Team865/octo-robot/docs/assets/robot_bot.png

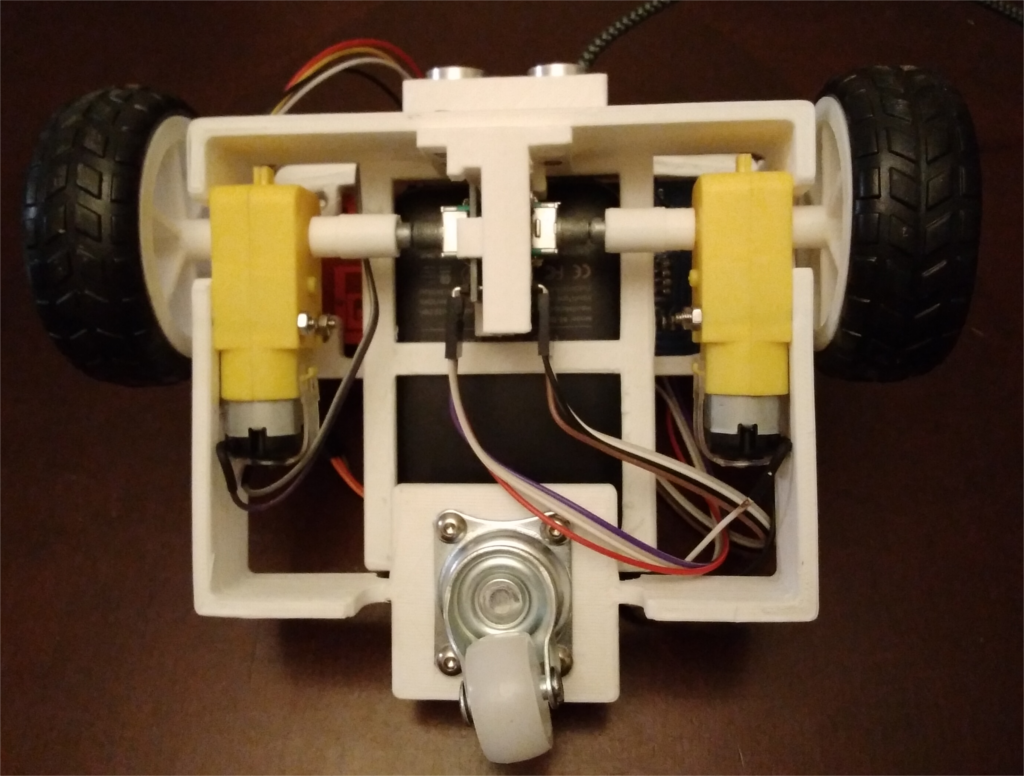
docs/assets/robot_bot.png
