Team865/octo-robot/docs/assets/robot_top.png

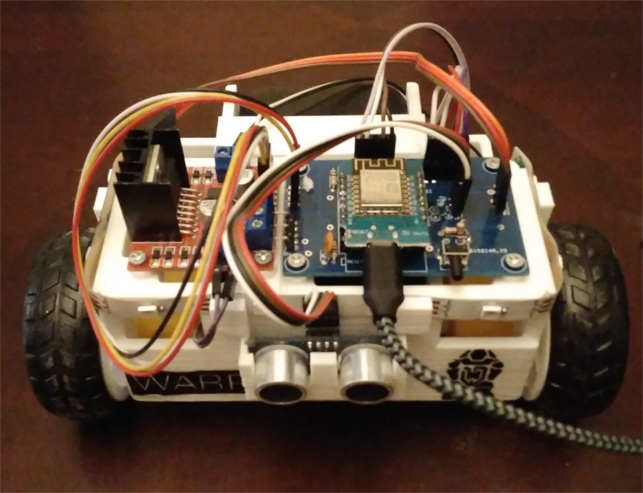
docs/assets/robot_top.png
