Team865/octo-robot/cad/NewRobotFrame/caster-wheel-roue-libre-1.snapshot.1/Caster Wheel d=20mm/Caster Wheel d=20mm.JPG

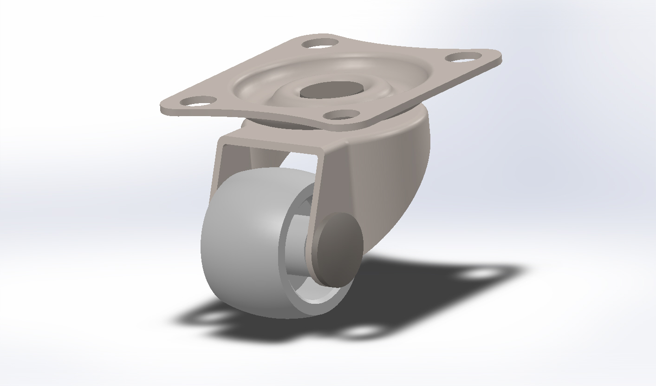
cad/NewRobotFrame/caster-wheel-roue-libre-1.snapshot.1/Caster Wheel d=20mm/Caster Wheel d=20mm.JPG
