Team865/octo-robot/docs/assets/screen_0.png

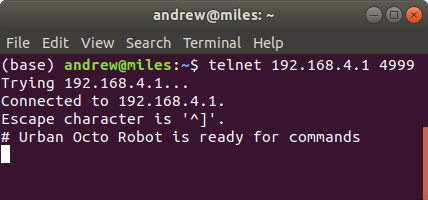
docs/assets/screen_0.png
