Team865/octo-robot/docs/assets/screen_1.png

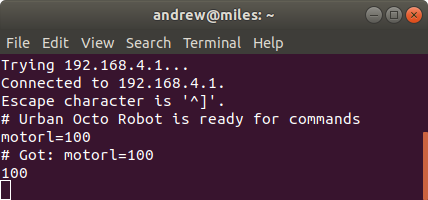
docs/assets/screen_1.png
