Team865/octo-robot/docs/assets/screen_2.png

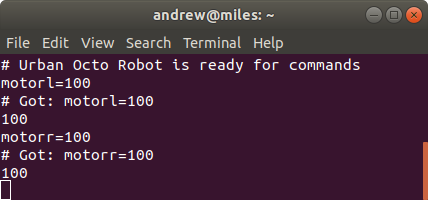
docs/assets/screen_2.png
