Team865/octo-robot/docs/assets/screen_3.png

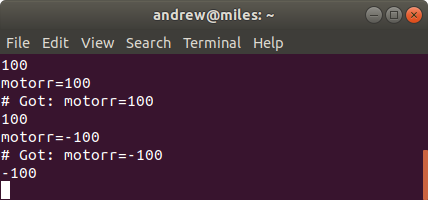
docs/assets/screen_3.png
