Team865/octo-robot/docs/assets/screen_9.png

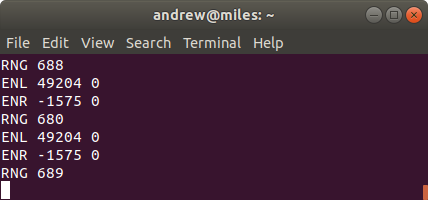
docs/assets/screen_9.png
