Team865/octo-robot/cad/NewRobotFrame/Assem2.sldasm

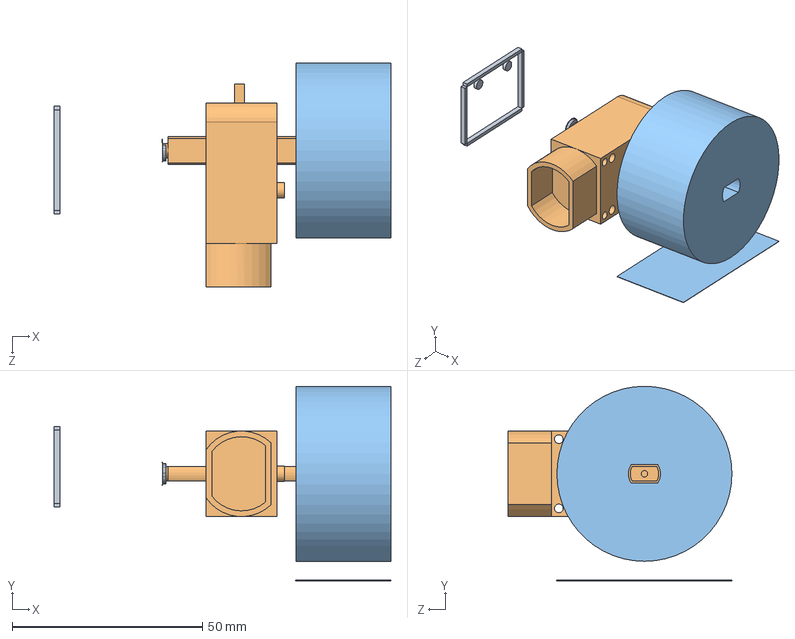
[picture p9: CAD file, 2020-09-12]
cad/NewRobotFrame/Assem2.sldasm
88.6 x 51.1 x 58.8 mm
Rotary_Encorder_Holder
Robot Wheel Motor Mount
Part1^Assem2
