Team865/octo-robot/cad/NewRobotFrame/Assem1.SLDASM

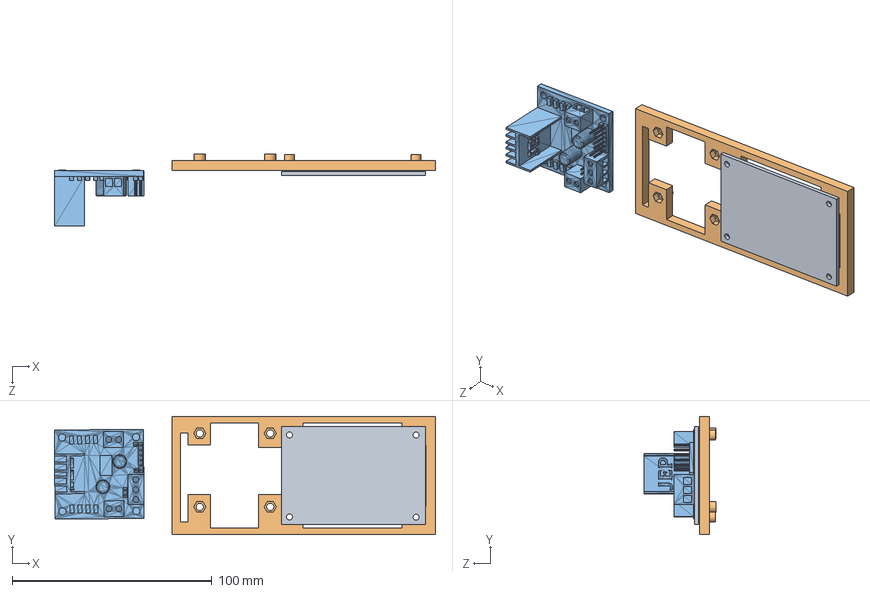
[picture p10: CAD file, 2020-09-12]
cad/NewRobotFrame/Assem1.SLDASM
190.7 x 59.2 x 36.2 mm
