Team865/octo-robot/cad/NewRobotFrame/caster-wheel-roue-libre-1.snapshot.1/Caster Wheel d=20mm/Caster Wheel d=20mm.SLDASM

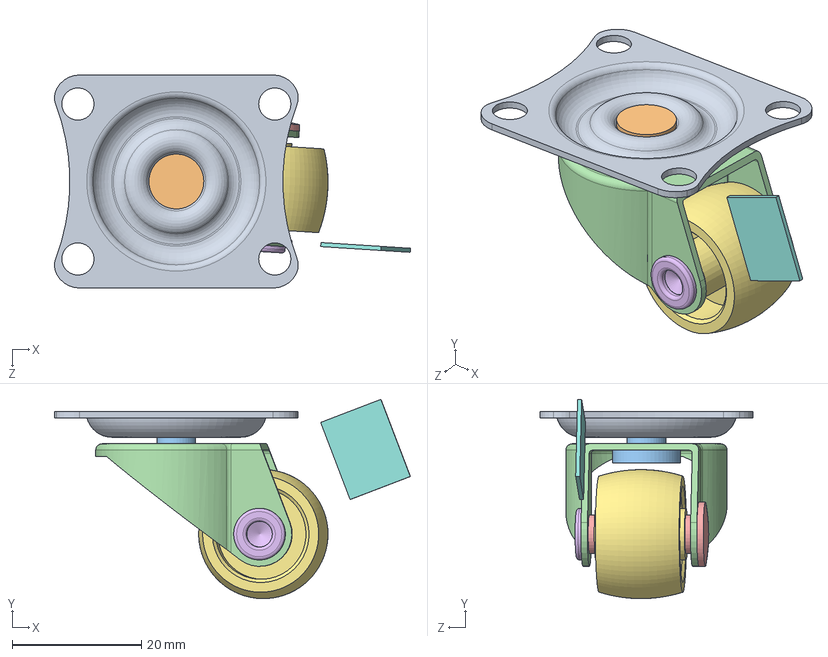
[picture p11: CAD file, 2020-09-12]
cad/NewRobotFrame/caster-wheel-roue-libre-1.snapshot.1/Caster Wheel d=20mm/Caster Wheel d=20mm.SLDASM
55.1 x 30.9 x 33.0 mm
Base
Rivet A
Rivet B
Chape
Rivet2 A
Rivet2 B
C - Galet
Part2^Caster Wheel d=20mm
