Team865/octo-robot/cad/NewRobotFrame/caster-wheel-roue-libre-1.snapshot.1/Caster Wheel d=20mm/B - Chape.SLDASM

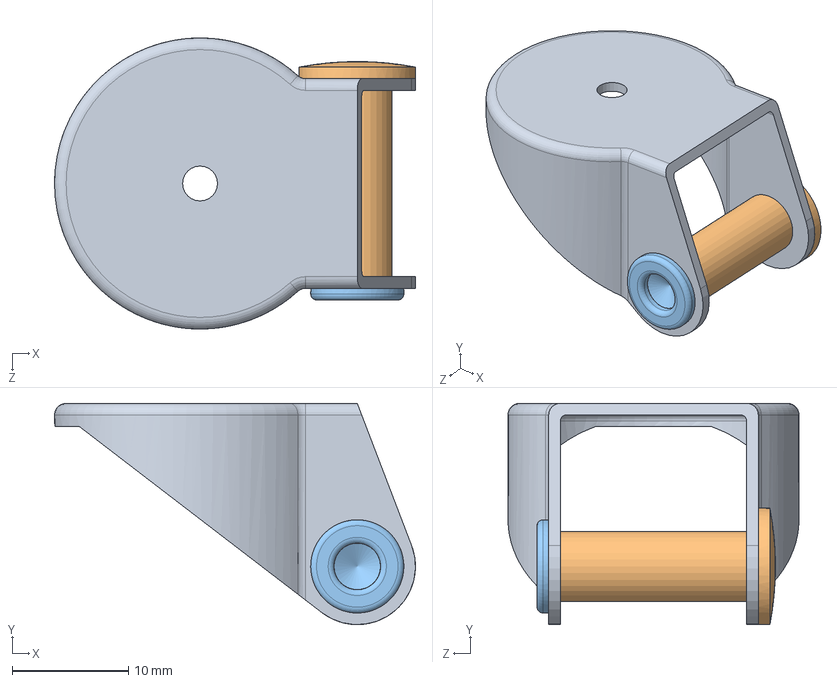
[picture p12: CAD file, 2020-09-12]
cad/NewRobotFrame/caster-wheel-roue-libre-1.snapshot.1/Caster Wheel d=20mm/B - Chape.SLDASM
31.0 x 19.0 x 25.0 mm
Chape
Rivet2 A
Rivet2 B
