Team865/octo-robot/cad/NewRobotFrame/caster-wheel-roue-libre-1.snapshot.1/Caster Wheel d=20mm/A - Base.SLDASM

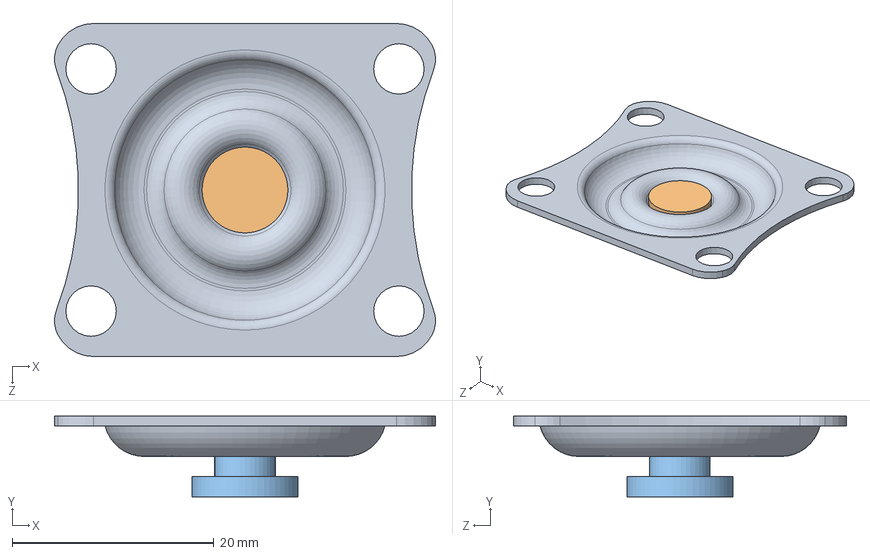
[picture p13: CAD file, 2020-09-12]
cad/NewRobotFrame/caster-wheel-roue-libre-1.snapshot.1/Caster Wheel d=20mm/A - Base.SLDASM
37.8 x 8.00 x 33.0 mm
Base
Rivet A
Rivet B
