Team865/octo-robot/cad/NewRobotFrame/caster-wheel-roue-libre-1.snapshot.1/Caster Wheel d=20mm - B - Chape-1 Rivet2 B-1.STL

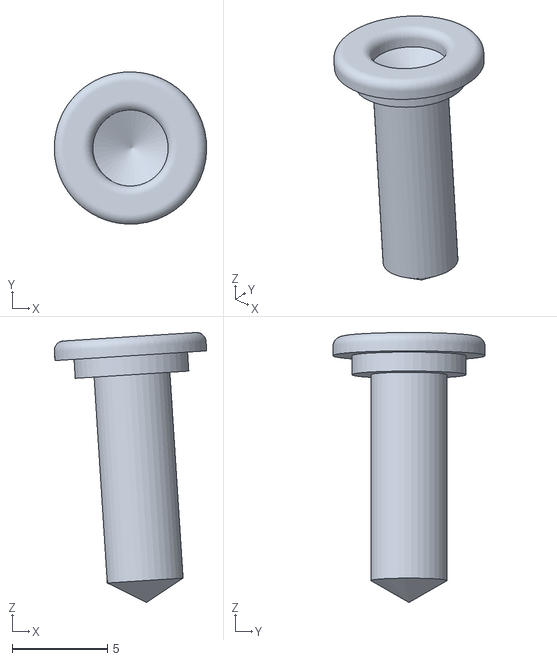
[picture p14: CAD file, 2020-09-12]
cad/NewRobotFrame/caster-wheel-roue-libre-1.snapshot.1/Caster Wheel d=20mm - B - Chape-1 Rivet2 B-1.STL
8.01 x 7.99 x 14.2
