Team865/octo-robot/cad/NewRobotFrame/caster-wheel-roue-libre-1.snapshot.1/Caster Wheel d=20mm/Base - Rivet A-1.STL

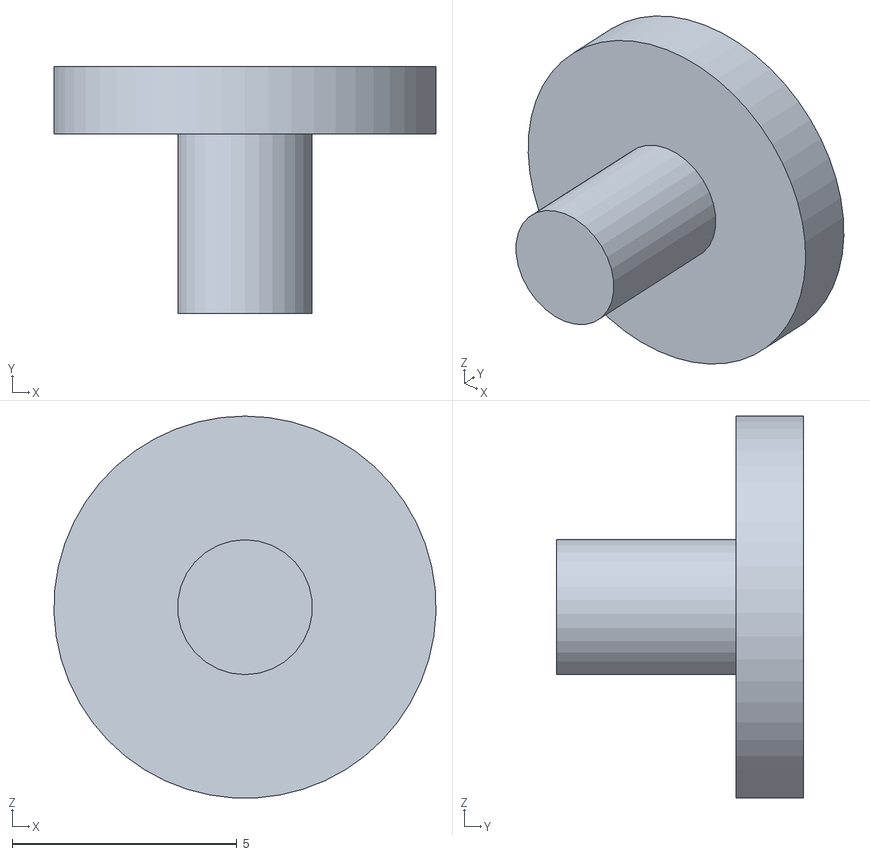
[picture p15: CAD file, 2020-09-12]
cad/NewRobotFrame/caster-wheel-roue-libre-1.snapshot.1/Caster Wheel d=20mm/Base - Rivet A-1.STL
8.50 x 5.50 x 8.49
