Team865/octo-robot/cad/rev_b/wheel.stl

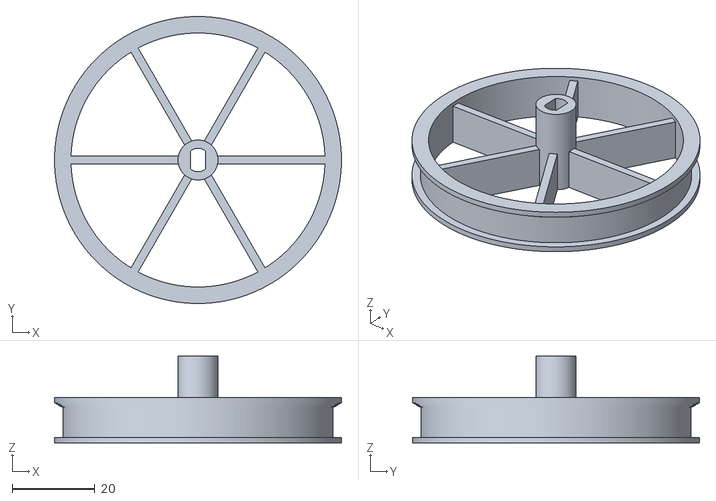
[picture p16: CAD file, 2021-10-17]
cad/rev_b/wheel.stl
69.5 x 69.5 x 21.0
