Team865/octo-robot/cad/shaft_coupler.stl

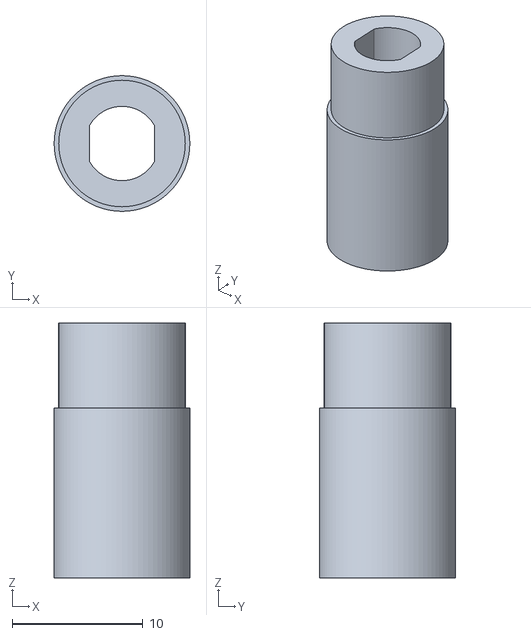
[picture p17: CAD file, 2020-08-18]
cad/shaft_coupler.stl
10.4 x 10.4 x 19.5
