Team865/octo-robot/cad/NewRobotFrame/caster-wheel-roue-libre-1.snapshot.1/Caster Wheel d=20mm/Caster Wheel d=20mm - A - Base-1 Base-1.STL

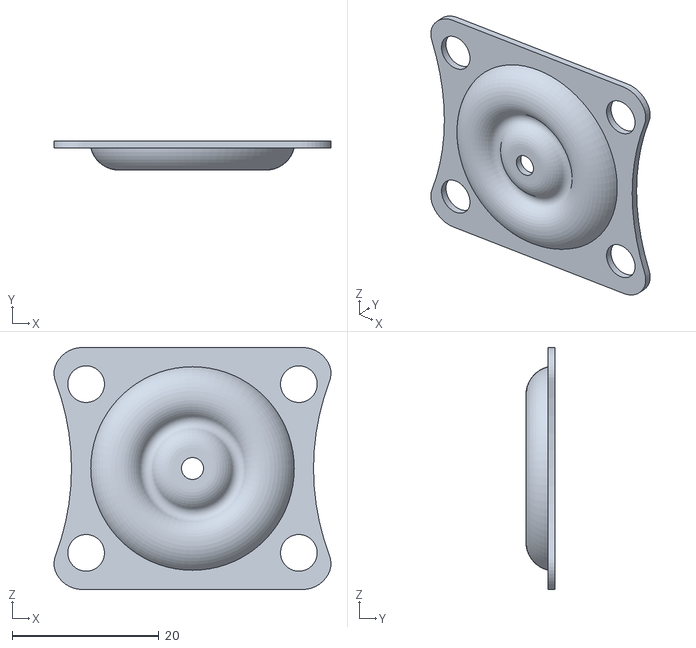
[picture p19: CAD file, 2020-09-12]
cad/NewRobotFrame/caster-wheel-roue-libre-1.snapshot.1/Caster Wheel d=20mm/Caster Wheel d=20mm - A - Base-1 Base-1.STL
37.8 x 4.00 x 33.0
