Team865/octo-robot/cad/rev_b/tire.stl

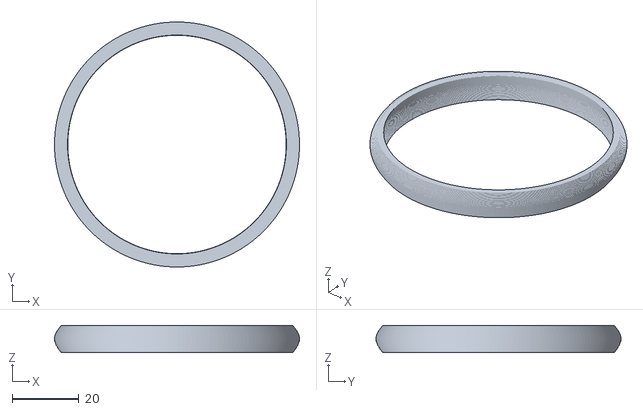
[picture p20: CAD file, 2021-10-17]
cad/rev_b/tire.stl
73.5 x 73.5 x 8.20
