Team865/octo-robot/cad/robot_model.SLDPRT

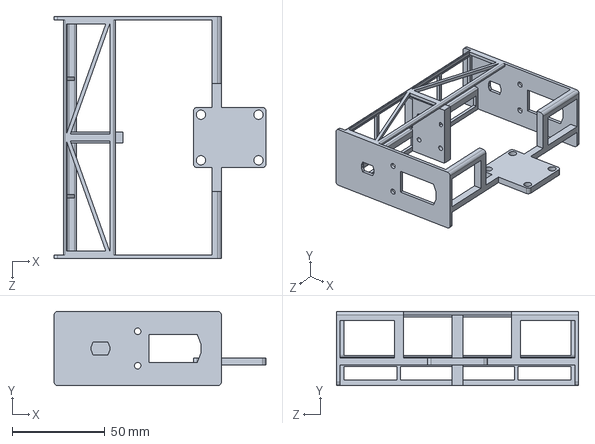
[picture p21: CAD file, 2020-07-27]
cad/robot_model.SLDPRT
114.0 x 40.0 x 130.3 mm
