Team865/octo-robot/cad/NewRobotFrame/caster-wheel-roue-libre-1.snapshot.1/Caster Wheel d=20mm - A - Base-1 Rivet B-1.STL

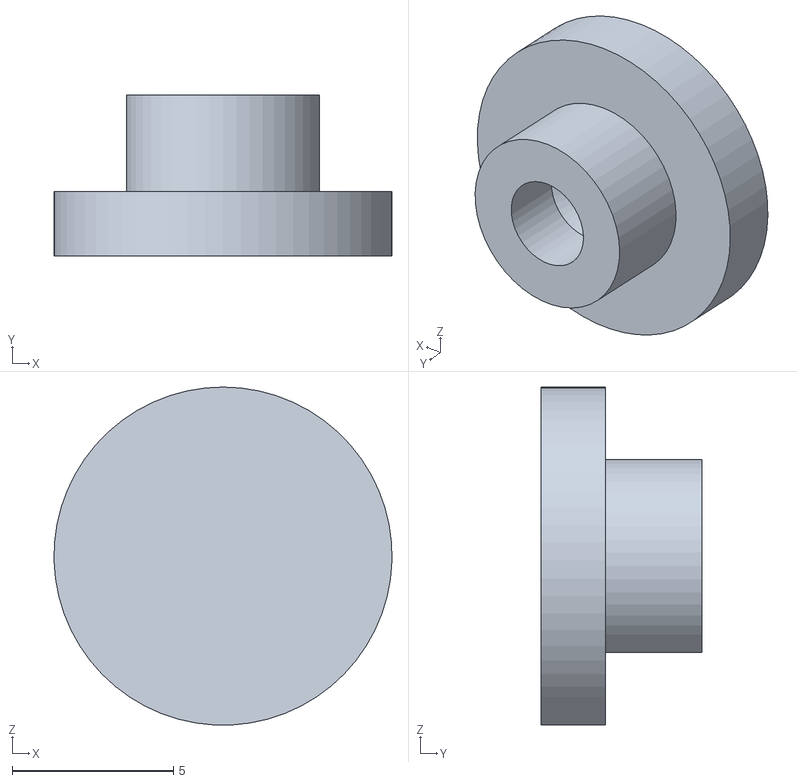
[picture p22: CAD file, 2020-09-12]
cad/NewRobotFrame/caster-wheel-roue-libre-1.snapshot.1/Caster Wheel d=20mm - A - Base-1 Rivet B-1.STL
10.5 x 5.00 x 10.5
