Team865/octo-robot/cad/NewRobotFrame/caster-wheel-roue-libre-1.snapshot.1/Caster Wheel d=20mm/Caster Wheel d=20mm - B - Chape-1 Rivet2 A-1.STL

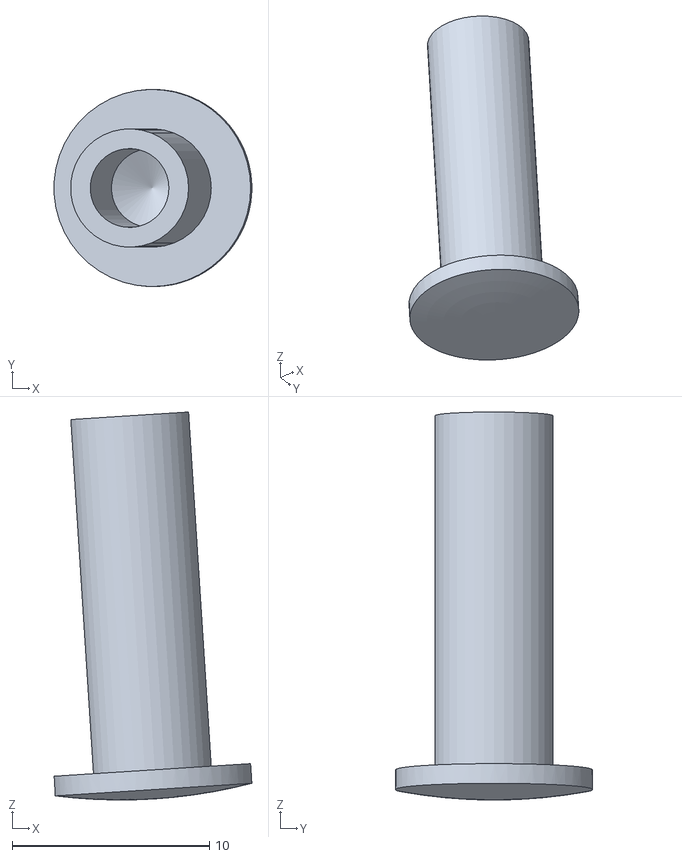
[picture p23: CAD file, 2020-09-12]
cad/NewRobotFrame/caster-wheel-roue-libre-1.snapshot.1/Caster Wheel d=20mm/Caster Wheel d=20mm - B - Chape-1 Rivet2 A-1.STL
10.0 x 10.0 x 19.7
