Team865/octo-robot/cad/NewRobotFrame/caster-wheel-roue-libre-1.snapshot.1/Caster Wheel d=20mm - B - Chape-1 Chape-1.STL

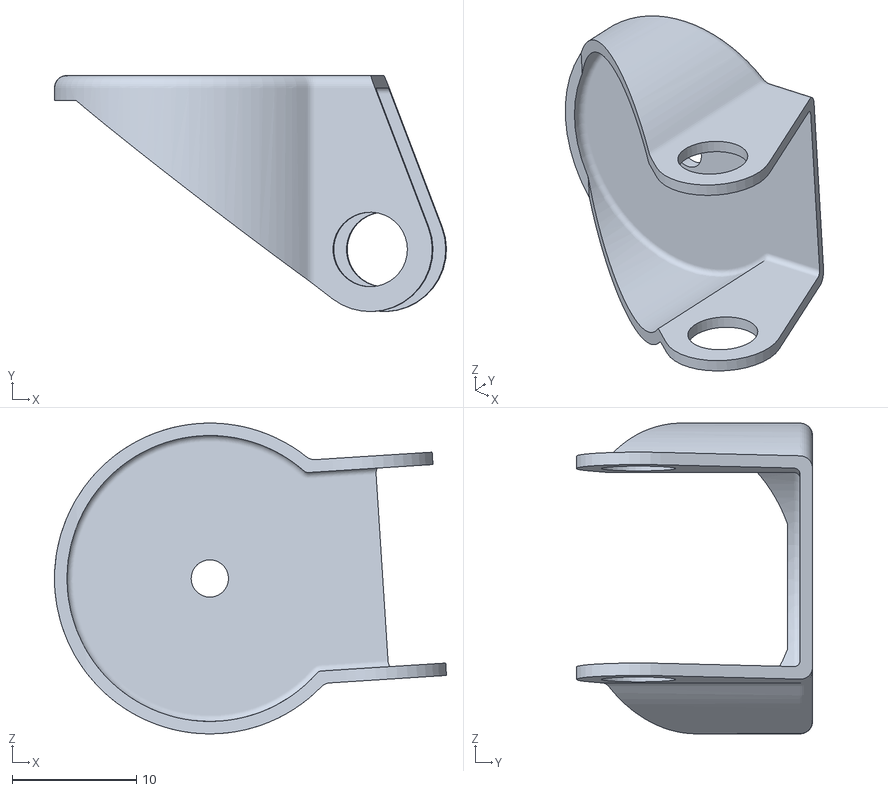
[picture p24: CAD file, 2020-09-12]
cad/NewRobotFrame/caster-wheel-roue-libre-1.snapshot.1/Caster Wheel d=20mm - B - Chape-1 Chape-1.STL
31.5 x 19.0 x 25.0
