Team865/octo-robot/cad/NewRobotFrame/caster-wheel-roue-libre-1.snapshot.1/Caster Wheel d=20mm/Rivet2 A.SLDPRT

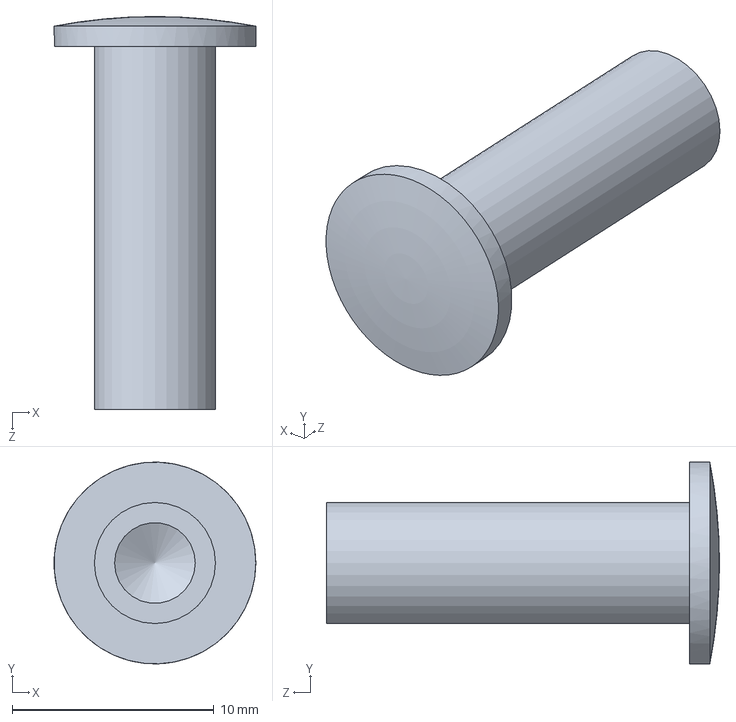
[picture p26: CAD file, 2020-09-12]
cad/NewRobotFrame/caster-wheel-roue-libre-1.snapshot.1/Caster Wheel d=20mm/Rivet2 A.SLDPRT
9.99 x 10.0 x 19.5 mm
