Team865/octo-robot/(list of files, cad)

Other CAD files:
cad/NewRobotFrame/framePrint2ButForRealsiesHopefuly.SLDPRT
cad/NewRobotFrame/caster-wheel-roue-libre-1.snapshot.1/Caster Wheel d=20mm/Caster Wheel d=20mm - A - Base-1 Base-1-1.STL
cad/NewRobotFrame/caster-wheel-roue-libre-1.snapshot.1/Caster Wheel d=20mm - A - Base-1 Rivet A-1.STL
cad/NewRobotFrame/caster-wheel-roue-libre-1.snapshot.1/Caster Wheel d=20mm/Caster Wheel d=20mm - A - Base-1 Rivet B-1-1.STL
cad/NewRobotFrame/caster-wheel-roue-libre-1.snapshot.1/Caster Wheel d=20mm/Caster Wheel d=20mm - A - Base-1 Rivet A-1.STL
cad/NewRobotFrame/caster-wheel-roue-libre-1.snapshot.1/Caster Wheel d=20mm/Base - Rivet B-1.STL
cad/NewRobotFrame/caster-wheel-roue-libre-1.snapshot.1/Caster Wheel d=20mm/Caster Wheel d=20mm - B - Chape-1 Rivet2 B-1-1.STL
cad/NewRobotFrame/caster-wheel-roue-libre-1.snapshot.1/Caster Wheel d=20mm/Galet.SLDPRT
cad/NewRobotFrame/caster-wheel-roue-libre-1.snapshot.1/Caster Wheel d=20mm/Caster Wheel d=20mm - C - Galet-1-1.STL
cad/NewRobotFrame/caster-wheel-roue-libre-1.snapshot.1/Caster Wheel d=20mm/Caster Wheel d=20mm - B - Chape-1 Rivet2 A-1-1.STL
cad/NewRobotFrame/caster-wheel-roue-libre-1.snapshot.1/Caster Wheel d=20mm/Base - Rivet B-1-1.STL
cad/NewRobotFrame/caster-wheel-roue-libre-1.snapshot.1/Caster Wheel d=20mm/Base - Base-1.STL
cad/NewRobotFrame/caster-wheel-roue-libre-1.snapshot.1/Caster Wheel d=20mm/Base - Rivet A-1-1.STL
cad/NewRobotFrame/caster-wheel-roue-libre-1.snapshot.1/Caster Wheel d=20mm/Base.SLDPRT
cad/NewRobotFrame/caster-wheel-roue-libre-1.snapshot.1/Caster Wheel d=20mm/Rivet A.SLDPRT
cad/NewRobotFrame/caster-wheel-roue-libre-1.snapshot.1/Caster Wheel d=20mm/Caster Wheel d=20mm - B - Chape-1 Chape-1-1.STL
cad/NewRobotFrame/caster-wheel-roue-libre-1.snapshot.1/Caster Wheel d=20mm/Caster Wheel d=20mm - A - Base-1 Rivet A-1-1.STL
cad/NewRobotFrame/caster-wheel-roue-libre-1.snapshot.1/Caster Wheel d=20mm/Base - Base-1-1.STL
cad/NewRobotFrame/caster-wheel-roue-libre-1.snapshot.1/Caster Wheel d=20mm/C - Galet.SLDPRT
cad/NewRobotFrame/caster-wheel-roue-libre-1.snapshot.1/Caster Wheel d=20mm/Rivet B.SLDPRT
cad/NewRobotFrame/caster-wheel-roue-libre-1.snapshot.1/Caster Wheel d=20mm/Rivet2 B.SLDPRT
cad/shaft_coupler.scad
cad/NewRobotFrame/caster-wheel-roue-libre-1.snapshot.1/Caster Wheel d=20mm/Caster Wheel d=20mm.IGS
