Team865/octo-robot/pcbs/rev_b/main.brd

## EAGLE design pcbs/rev_b/main.brd (2021-10-17)

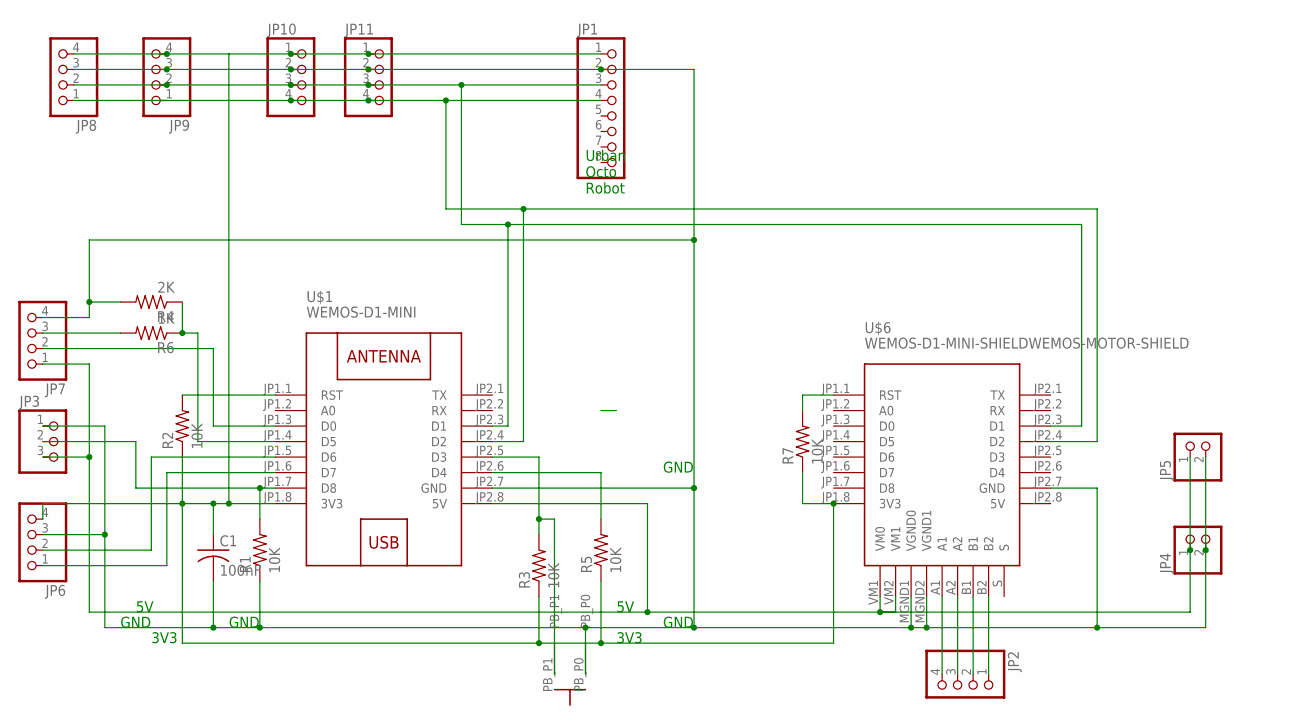
[picture p35: schematic main.sch]

Parts:
C1: 100nF; C050-024X044
JP1: PINHD-1X8; 1X08
JP2: PINHD-1X4/90; 1X04/90
JP3: PINHD-1X3; 1X03
JP4, JP5: PINHD-1X2; 1X02
JP6, JP7, JP8, JP9, JP10, JP11: PINHD-1X4; 1X04
R1, R2, R3, R5, R7: 10K; 0204/7
R4: 2K; 0309V
R6: 1K; 0309V
U$1: WEMOS-D1-MINI
U$6: WEMOS-D1-MINI-SHIELDWEMOS-MOTOR-SHIELD; WEMOS-D1-MINI-SHIELD
U$7: BUTTON6X6X10MMSIDE

Connections:
5V: U$6.JP2.8 (5V)
unnamed: JP2.4, U$6.A1
unnamed: R7.2, U$6.JP1.1 (RST)
unnamed: JP3.3, JP4.1, JP5.1, JP7.1, U$1.JP2.8 (5V), U$6.VM1 (VM0), U$6.VM2 (VM1)
unnamed: JP7.3, R6.2
unnamed: JP2.3, U$6.A2
unnamed: JP6.2, U$1.JP1.5 (D6)
unnamed: R5.2, U$1.JP2.6 (D4)
unnamed: R4.1, R6.1, U$1.JP1.4 (D5)
unnamed: R2.2, U$1.JP1.1 (RST)
unnamed: JP3.2, R1.2, U$1.JP1.7 (D8)
unnamed: JP2.2, U$6.B1
unnamed: JP2.1, U$6.B2
unnamed: R3.2, U$1.JP2.5 (D3), U$7.PB_P1
unnamed: JP7.2, U$1.JP1.3 (D0)
unnamed: JP6.1, U$1.JP1.6 (D7)
unnamed: C1.1, JP1.1, JP6.4, JP8.4, JP9.4, JP10.1, JP11.1, R2.1, R3.1, R5.1, R7.1, U$1.JP1.8 (3V3), U$6.JP1.8 (3V3)
unnamed: C1.2, JP1.2, JP3.1, JP4.2, JP5.2, JP6.3, JP7.4, JP8.3, JP9.3, JP10.2, JP11.2, R1.1, R4.2, U$1.JP2.7 (GND), U$6.JP2.7 (GND), U$6.MGND1 (VGND0), U$6.MGND2 (VGND1), U$7.PB_P0
unnamed: JP1.3, JP8.2, JP9.2, JP10.3, JP11.3, U$1.JP2.3 (D1), U$6.JP2.3 (D1)
unnamed: JP1.4, JP8.1, JP9.1, JP10.4, JP11.4, U$1.JP2.4 (D2), U$6.JP2.4 (D2)

Notes on the sheet:
GND
3V3
Urban Octo Robot

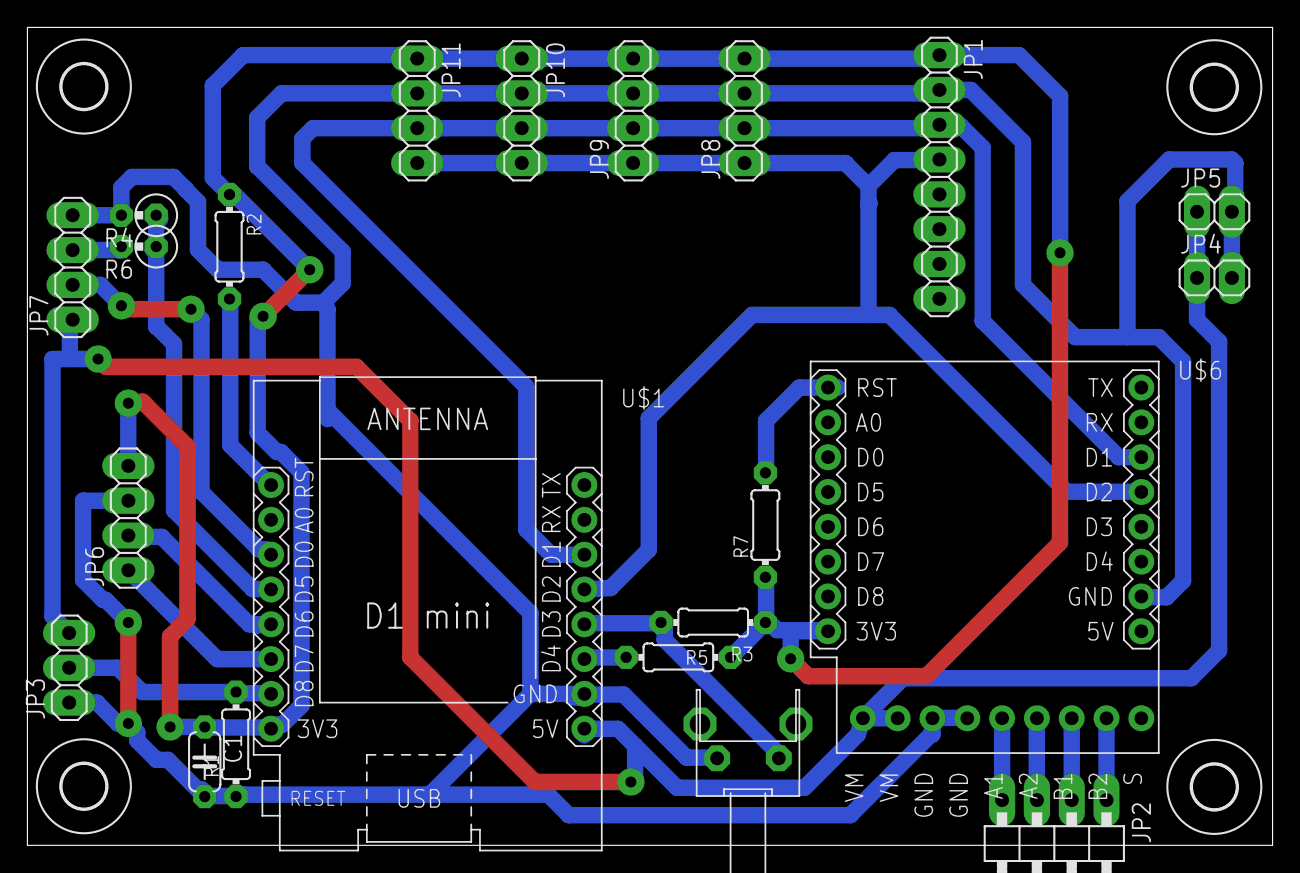
[picture p36: board pcbs/rev_b/main.brd from above]

Board: 2 copper layers, 90.9 x 59.7 mm, 26 parts (0 on the bottom side), 19 nets.

Other parts of the board:
U$2, U$3, U$4, U$5: 3,2
