Team865/octo-robot/pcbs/rev_a/main.brd

## EAGLE design pcbs/rev_a/main.brd (2020-08-18, an earlier design)

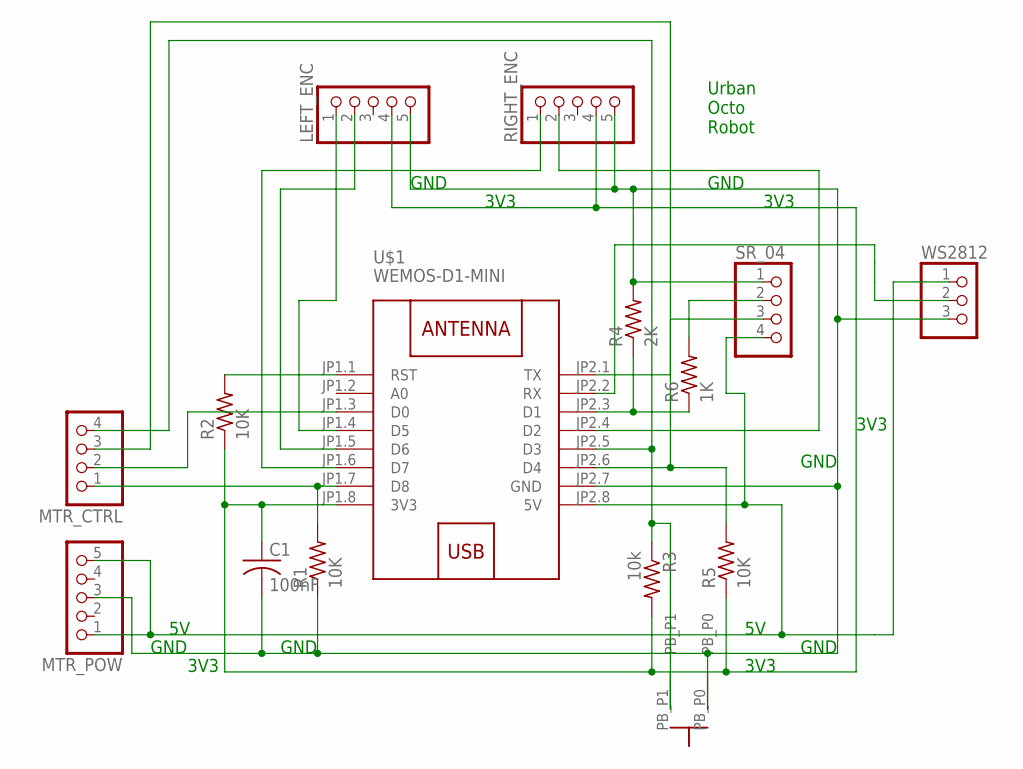
[picture p37: schematic main.sch]

Parts:
C1: 100nF; C050-024X044
LEFT_ENC: PINHD-1X5; 1X05
MTR_CTRL: PINHD-1X4; 1X04
MTR_POW: PINHD-1X5/90; 1X05/90
R1, R2, R5: 10K; 0204/7
R3: 10k; 0207/2V
R4: 2K; 0309V
R6: 1K; 0309V
RIGHT_ENC: PINHD-1X5; 1X05
SR_04: PINHD-1X4; 1X04
U$1: WEMOS-D1-MINI
U$7: BUTTON6X6X10MMSIDE
WS2812: PINHD-1X3; 1X03

Connections:
unnamed: U$1.JP2.2 (RX), WS2812.2
unnamed: MTR_POW.1, MTR_POW.5, SR_04.4, U$1.JP2.8 (5V), WS2812.1
unnamed: LEFT_ENC.1, U$1.JP1.4 (D5)
unnamed: MTR_CTRL.2, U$1.JP1.3 (D0)
unnamed: RIGHT_ENC.2, U$1.JP2.4 (D2)
unnamed: LEFT_ENC.2, U$1.JP1.5 (D6)
unnamed: RIGHT_ENC.1, U$1.JP1.6 (D7)
unnamed: C1.1, LEFT_ENC.4, R2.1, R3.2, R5.1, RIGHT_ENC.4, U$1.JP1.8 (3V3)
unnamed: R6.2, SR_04.2
unnamed: MTR_CTRL.4, R3.1, U$1.JP2.5 (D3), U$7.PB_P1
unnamed: R4.1, R6.1, U$1.JP2.3 (D1)
unnamed: SR_04.3, U$1.JP2.1 (TX)
unnamed: MTR_CTRL.3, R5.2, U$1.JP2.6 (D4)
unnamed: R2.2, U$1.JP1.1 (RST)
unnamed: MTR_CTRL.1, R1.2, U$1.JP1.7 (D8)
unnamed: C1.2, LEFT_ENC.5, MTR_POW.3, R1.1, R4.2, RIGHT_ENC.5, SR_04.1, U$1.JP2.7 (GND), U$7.PB_P0, WS2812.3

Notes on the sheet:
GND
3V3
Urban Octo Robot

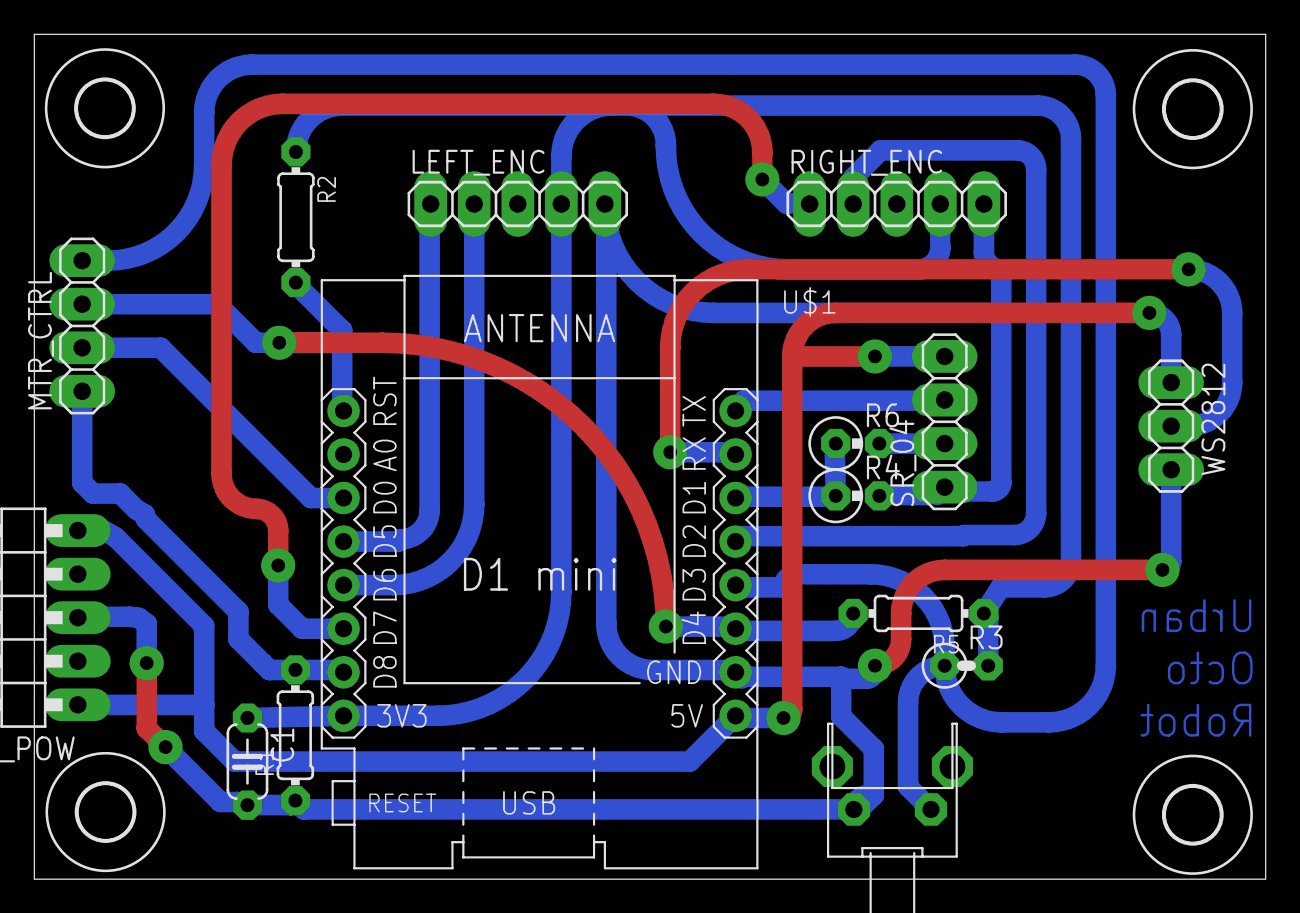
[picture p38: board pcbs/rev_a/main.brd from above]

Board: 2 copper layers, 71.8 x 49.3 mm, 19 parts (0 on the bottom side), 16 nets.

Other parts of the board:
U$2, U$3, U$4, U$5: 3,2
