Team865/octo-robot/firmware/firmware_v2/hardware_esp8266.cpp

#include <ESP8266WiFi.h>
#include <Adafruit_NeoPixel.h>
#include "hardware_esp8266.h"
#include <memory>
#include "Wire.h"

namespace
{
const std::unordered_map<HW::Pin, int, EnumHash > pinMap = 
{
  { HW::Pin::SR04_TRIG,       16    },
  { HW::Pin::SR04_ECHO,       14    },
  { HW::Pin::LED_PIN,         15    }
};

constexpr int LOCAL_LED_PIN=15;

const std::vector< HW::Pin > interruptInputs = {
  HW::Pin::SR04_ECHO
};

const std::unordered_map<HW::PinState, int, EnumHash > pinStateMap = {
  { HW::PinState::MOTOR_POS,      HIGH  },
  { HW::PinState::MOTOR_NEG,      LOW   },
  { HW::PinState::ECHO_ON,        HIGH  },
  { HW::PinState::ECHO_OFF,       LOW   }
};

class InputInterruptHandler
{
  public:

  InputInterruptHandler( std::shared_ptr< Time::HST> hstArg, HW::Pin pin )
    : hst{ hstArg }
  {
    // Cache the actual pin
    esp8266Pin = pinMap.at( pin ); 
  }
  
  void ICACHE_RAM_ATTR interrupt()
  {
    // Record the pin state & time, and get out of here.
    events.write( Util::IPinEvent(
        digitalRead( esp8266Pin ) == HIGH ? 
            HW::PinState::INPUT_HIGH : 
            HW::PinState::INPUT_LOW,
        hst->usSinceDeviceStart())
    );
  }

  HW::IEvent& getEvents() {
    return events;
  }

  private:
  HW::IEvent events;
  std::shared_ptr< Time::HST > hst; 
  int esp8266Pin;
};

std::array<int, static_cast<size_t>(HW::Pin::END_OF_PINS)  > fastAbstractToRealPin;
std::array<int, static_cast<size_t>(HW::PinState::END_OF_PIN_STATES) > fastAbstractToRealPinState; 
std::array<std::unique_ptr<InputInterruptHandler>, static_cast<size_t>(HW::Pin::END_OF_PINS ) > pinToInputHandler;

//
// Programming with raw pointers and arrays, just like the 90s.
// The ESP8266 interrupt handler HAS to be in RAM.  Raw arrays and
// smart pointers aren't good C++ anymore, but in this case they're
// easy to reason about.
// 
InputInterruptHandler* pinToInputHandlerRaw[ static_cast<size_t>(HW::Pin::END_OF_PINS) ];


void ICACHE_RAM_ATTR echoPinInt()
{
  InputInterruptHandler* handler = pinToInputHandlerRaw[ static_cast<size_t>(HW::Pin::SR04_ECHO ) ];
  handler->interrupt();
}


Adafruit_NeoPixel strip = Adafruit_NeoPixel( 8, LOCAL_LED_PIN, NEO_GRB + NEO_KHZ800 );

} // end anonymous namespace

namespace HW {
HardwareESP8266::HardwareESP8266( std::shared_ptr< Time::HST> hst )
{
  Wire.begin();
  //sw.enablePullups(true);
  sw.setDelay_us(5);
  sw.setTimeout(1000);
  sw.setTxBuffer(swTxBuffer, sizeof(swTxBuffer));
  sw.setRxBuffer(swRxBuffer, sizeof(swRxBuffer));
  sw.begin();
  // create cache for pin id
  for ( size_t index = 0 ; index < fastAbstractToRealPin.size(); ++index ) 
  {
    fastAbstractToRealPin[ index ] = 0;
  }
  for ( const auto& entry :  pinMap ) 
  {
    size_t index = static_cast<size_t>(entry.first);
    if ( index >= fastAbstractToRealPin.size() ) {
      for (;; );    // think of it like an assert
    }
    fastAbstractToRealPin[ index ] = entry.second;
  }
  // create cache for pin state
  for ( size_t index = 0 ; index < fastAbstractToRealPinState.size(); ++index ) 
  {
    fastAbstractToRealPinState[ index ] = 0;
  }
  for ( const auto& entry : pinStateMap) 
  {
    size_t index = static_cast<size_t>(entry.first);
    if ( index >= fastAbstractToRealPinState.size() ) {
      for (;; );    // think of it like an assert
    }
    fastAbstractToRealPinState[ index ] = entry.second;
  }


  // todo - constants
  pinMode( pinMap.at( Pin::SR04_TRIG ), FUNCTION_3 );
  pinMode( pinMap.at( Pin::LED_PIN),    FUNCTION_3 );
  pinMode( pinMap.at( Pin::LED_PIN),    OUTPUT );


  for ( size_t index = 0; index < static_cast<size_t>(HW::Pin::END_OF_PINS); ++index ) {
    pinToInputHandlerRaw[ index ] = nullptr;
  }
  for( Pin interruptInput : interruptInputs ) 
  {
    size_t slot = static_cast<size_t>(interruptInput);
    pinToInputHandler[ slot ] = std::unique_ptr<InputInterruptHandler>( new InputInterruptHandler(hst, interruptInput ));
    pinToInputHandlerRaw[ slot ] = pinToInputHandler[ slot ].get();
  }


  pinMode( pinMap.at( Pin::SR04_ECHO     ), INPUT );
  attachInterrupt( digitalPinToInterrupt( pinMap.at( Pin::SR04_ECHO) ), echoPinInt, CHANGE );
  strip.begin();

  for ( int i = 0; i < 8; ++i ) {
    LEDSet( i, 0, 128, 0 );
  }
  LEDUpdate();
}

void HardwareESP8266::DigitalWrite( Pin pin, PinState state )
{
  digitalWrite( 
      fastAbstractToRealPin     [ static_cast<size_t> (pin)   ],
      fastAbstractToRealPinState[ static_cast<size_t> (state) ] );
}

void HardwareESP8266::PinMode( Pin pin, PinIOMode mode )
{
  int actualPin = pinMap.at( pin );
  pinMode( actualPin, mode == PinIOMode::M_OUTPUT ? OUTPUT : INPUT );
}

HW::PinState HardwareESP8266::DigitalRead( Pin pin)
{
  const int actualPin = fastAbstractToRealPin[ static_cast<size_t>( pin ) ];
  const int actualState = digitalRead( actualPin );
  return actualState == HIGH ? PinState::INPUT_HIGH : PinState::INPUT_LOW;
}

unsigned int HardwareESP8266::AnalogRead( Pin pin)
{
  (void) pin;
  return analogRead( A0 );
}

IEvent& HardwareESP8266::GetInputEvents( Pin pin )
{
  auto& handler = pinToInputHandler[ static_cast<size_t>( pin ) ];
  return handler->getEvents();
}

void HardwareESP8266::LEDSet( unsigned int led, unsigned char r, unsigned char g, unsigned char b )
{
  strip.setPixelColor( led, strip.Color( r, g, b ));
}

void HardwareESP8266::LEDUpdate()
{
  strip.show();
}
}
