Team865/octo-robot/firmware/firmware_v2/command_motor.cpp

#include "command_motor.h"
#include "wifi_debug_ostream.h"

namespace Command{
//=======================================================================
Motor::Motor( 
  std::shared_ptr<HW::I> hwiArg,
  std::shared_ptr<DebugInterface> debugArg,
  int motorNumArg
) :
    dir { _STOP }, speedAsPercent{ 0 }, counter{ 0 }, debug{debugArg}, hwi{hwiArg}, motorNum{motorNumArg}
{
    int nDevices;
    int address;
    bool error;

    (*debugArg) << "Motor Up\n";
    (*debugArg) << "Scanning Bus 0 Devices...\n";
    nDevices = 0;
    for(address = 1; address < 127; address++){
        hwi->WireBeginTransmission(0, address);
        error = hwi->WireEndTransmission(0);
        if(error){
            (*debug) << "I2C device found at address " << address << "\n";
        }
    }

    (*debugArg) << "Scanning Bus 1 Devices...\n";
    nDevices = 0;
    for(address = 1; address < 127; address++){
        hwi->WireBeginTransmission(1, address);
        error = hwi->WireEndTransmission(1);
        if(error){
            (*debug) << "I2C device found at address " << address << "\n";
        }
    }
    //Set frequency
    int freq = 1000;
    hwi->WireBeginTransmission(0, 30);
    hwi->WireWrite(0, ((freq >> 16) & 0xff) & 0x0f );
    hwi->WireWrite(0, (freq >> 16)  & 0xff );
    hwi->WireWrite(0, (freq >> 8 )  & 0xff );
    hwi->WireWrite(0, (freq >> 0 )  & 0xff );
    hwi->WireEndTransmission(0);
}

//
// Standard execute method
//
// Controls the speed of the motor by pulsing power to the motor.  If the
// motor is 50% on then execute generates a pulse that's "on" 50% of the
// time.  If the motor is 75% on, the pulse is "on" 75% of the time.
//
// See https://socratic.org/questions/how-do-you-calculate-the-period-and-frequency for terms
// 
// 1. Figure out if we're turning the motor on or off.
// 2. Figure out the pulse duration.  This is a function of speed
// 3. Early exit if we're spending no time in the current state
// 4. Set the hardware to the new state
// 5. Tell the schedule to pause, as per the pulse's duration
// 
Time::TimeUS Motor::execute() 
{

  return Time::TimeUS(100000);
}

//
// Set the current speed and direction
// 
void Motor::setSpeed( int percent )
{
  int pwr_val;
  bool error;
  dir = percent >= 0 ? _CW :
    percent <= 0 ? _CCW : _STOP;
  speedAsPercent = percent >= 0 ? percent : -percent;

  pwr_val = speedAsPercent*100;
  pwr_val = pwr_val > 10000 ? 100000 : pwr_val;
  hwi->WireBeginTransmission(0, 0x30);
  hwi->WireWrite(0, motorNum | 0x10);
  hwi->WireWrite(0, dir);
  hwi->WireWrite(0, pwr_val >> 8);
  hwi->WireWrite(0, pwr_val);
  error = hwi->WireEndTransmission(0);
  if(error){
      (*debug) << "Transmission success";
  }
  else{
      (*debug) << "Transmission failure";
  }
}


//
// Get debug name
//  
const char* Motor::debugName()
{
  return "L298 Motor Control";
}


} // End Command Namespace


#ifdef TODO
#include "WEMOS_Motor.h"

int pwm;

//Motor shiled I2C Address: 0x30
//PWM frequency: 1000Hz(1kHz)
Motor M1(0x30,_MOTOR_A, 1000);//Motor A
Motor M2(0x30,_MOTOR_B, 1000);//Motor B


void setup2() {
  Serial.begin(115200);
}

void loop2() {

  for (pwm = 0; pwm <= 100; pwm++)
  {
    M1.setmotor( _CW, pwm);
    M2.setmotor(_CW, 100-pwm);
    Serial.printf("A:%d%, B:%d%, DIR:CW\r\n", pwm,100-pwm);
  }
  
  M1.setmotor(_STOP);
  M2.setmotor( _STOP);
  Serial.println("Motor A&B STOP");
  delay(200);
  
  for (pwm = 0; pwm <=100; pwm++)
  {
    M1.setmotor(_CCW, pwm);
    M2.setmotor(_CCW, 100-pwm);
    Serial.printf("A:%d%, B:%d%, DIR:CCW\r\n", pwm,100-pwm);

  }
  
  M1.setmotor(_STOP);
  M2.setmotor( _STOP);
  delay(200);
  Serial.println("Motor A&B STOP");

  M1.setmotor(_SHORT_BRAKE);
  M2.setmotor( _SHORT_BRAKE);
  Serial.println("Motor A&B SHORT BRAKE");  
  delay(1000);
  
  M1.setmotor(_STANDBY);//Both Motor standby
  //M2.setmotor( _STANDBY);
  Serial.println("Motor A&B STANDBY");  
  delay(1000);
  
}

#endif
