Team865/octo-robot/(commit log)

2020-06-06 Initial modifications. Set up a command wrangler to parse and send commands to devices.
2020-06-06 Fix ESP8266 specific code.
    [command_parser.h, command_wrangler.h, hardware_esp8266.cpp, main.cpp]
2020-06-06 Motor controller now works for a single motor
2020-06-07 fix compile bugs caused by file removal
    [command_wrangler.h]
2020-06-07 Switch the time since 1970 interface into a typesafe into
2020-06-07 More type safety. This one caught a bug.
    [action_manager.cpp, action_manager.h, basic_types.h, hardware_esp8266.cpp, main.cpp, time_esp8266.cpp, time_interface.h]
2020-06-07 Code readability changes. Also make the index into the action slot array more typesafe.
2020-06-13 Add encoder command
2020-06-13 Begin adding the concept of a high speed timer
2020-06-14 Add a us timer based on the ESP8266's CPU count timer.
2020-06-15 Have profile gather data from the high speed timer
2020-06-15 Create a reset command for the profiler
    [command_parser.cpp, command_parser.h, command_process_input.cpp, command_process_input.h, command_scheduler.cpp, command_scheduler.h, main.cpp, util_profile.cpp]
2020-06-20 ESP8266 wifi service works with the redone interface. The tail latency on the command that moves data to and from the net is not fantasitic.
    ProcessInput 50% = 11uS 90% = 27uS 98% = 43uS max = 399uS
    L298 Motor Control 50% = 9uS 90% = 10uS 98% = 16uS max = 37uS
    Encoder 50% = 11uS 90% = 11uS 98% = 11uS max = 137uS
    ConnectWatch 50% = 12uS 90% = 19uS 98% = 23uS max = 50uS
    NetConnection 50% = 31uS 90% = 31uS 98% = 31uS max = 2271uS
    ESP8266 HST 50% = 22uS 90% = 23uS 98% = 23uS max = 26uS
2020-07-04 Add a command to send encoder data (and anything else) to the host.
2020-07-04 Switch firmward so the robot creates an access point. Greatly improves latency, which will be helpful for prototyping
2020-07-05 Interface for the second motor, "motor b", on GPIO 2 & 0
2020-07-06 Add second encoder
2020-07-12 Added solidworks file for robot skeliton.
    [robot_model.SLDPRT]
2020-07-15 Updated robot model.
    [robot_model.SLDPRT]
2020-07-27 - Start of a PCB that will make the cabling on the robot easier - Update firmware with the PCB's pins
    [main.brd, main.sch]
2020-08-08 First candidate board
    [main.brd, main.sch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]
2020-08-12 Begin work on the sonar range finder command
2020-08-16 Work on PCB and firmware updates for the SR04 range finder - Move PCB pinouts. I wasn't able to use the TX or RX pins as inputs - Add a WS2812 plug. It might be usable with the last port, and it does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
    [main.brd, main.sch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]
2020-08-18 Move GPIOs so the firmware can (hopefully) use interrupts instead of polling in encoders.
    [main.brd, main.sch, shaft_coupler.scad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]
2020-08-18 Commit files sent to jlpcb for PCB fabrication
2020-08-18 Update images to match the boards that are being fabricated
2020-08-19 Get firmware simulator and unit tests working again. Fix the pulse send timout on the sr04 command.
    [command_sr04.cpp, main.cpp]
2020-08-19 Rename encoder commands to "l" and "r" instead of "a" and "b". L = left, R = right
2020-08-19 Create a pipe data structure for timing Input pin events. This will be used, later, by the encoders driver, and probably the SR04 driver.
2020-08-19 Move Pin, PinState, and names out of the hardware interface. Enables moving the core hardware enums into a light weight types file.
2020-08-19 Split hardware_interface.h into... - hardware_interface.h, which contains the actual interface to the hardware - hardware_types.h, a light weight class for pin related enums & names
2020-08-20 Create a utility for merging two streams of input events in chronological order. For the encoders, which have two pins.
2020-08-20 Create a debouncing ipin event filter + tests.
2020-08-20 Change filters to use pointers instead of references. References were too fancy for the Arduino C++ compiler I'm using
2020-08-20 Step to switching the encoders over to a fully interrupt driven pin model. Switch the encoder command over to an event driven model. The hardware state is still effectively polled under the hood, but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
    [command_encoder.cpp]
2020-08-23 Add "interruptable function" macro. The intention is a macro that tells the ESP8266 compiler to put functions into ram so they can be used in interrupt functions. Use more primitive data structures (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
2020-08-24 Encoder and debugging features - Work to help the encoder modules compute rotation speed. - Renaming. Encoder and Motor modules are now left and right. - There is now a motora command that turns both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
2020-08-24 Switch encoders to interrupt driven input Also fix a crash bug in the profiling code.
    [basic_types.h, command_encoder.cpp, hardware_esp8266.cpp, time_esp8266hst.cpp, time_esp8266hst.h, util_profile.cpp]
2020-08-25 Switch SR04 range finder to use interrupt driven IO infrastructure.
2020-08-25 Add the sonar range finder to the datasend command. datasend=1 will now generate a RNG reading that has the distance of the nearest object in mm Limit datasend to 10 samples / second - the update tim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
2020-08-25 Simplification. Class-wide distance is no longer needed.
    [command_sr04.cpp, command_sr04.h]
2020-08-25 Have the SR04 take the medium of 3 samples.
2020-08-25 Hardware support for WS2812 LED strips
2020-08-25 Hook LEDs up to encoder and sonar range finder. Gives visual feedback on the robot state that may help with debugging.
2020-09-12 Added new robot frame CAD.
    [A - Base.SLDASM, Assem1.SLDASM, Assem2.sldasm, B - Chape.SLDASM, Base - Base-1-1.STL, Base - Base-1.STL, Base - Rivet A-1-1.STL, Base - Rivet A-1.STL]
2020-09-17 Tune range finder LEDs - Ignore invalid sensor requests. The green flashes are visually distracting - Move the "far" from 140cm to 50cm. - Remove magic number.
2020-09-17 Finished fake FIRST encoder class.
2020-09-17 Added finishing touches on the CAD.
    [framePrint2ButForRealsiesHopefuly.SLDPRT]
2020-09-24 Tighten up the encoders - Do debouncing inside the interrupts. The odd encoder is very noisy and overload the event pipe. When that happens the encoder loses its value. - Tighten up the encoder veloc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
    [command_encoder.cpp, command_encoder.h, command_motor.h, hardware_interface.h, util_ipinevents.h]
2020-09-24 Increase the polling time on the encoders from 10 times / second to 100 times / second. - Should improve the quality of the data being sent back to the host computer a tiny bit.
2020-12-14 Work on position/ autonomous tutorial code.... - OctoDriveSubsystem.java: Modify to try to compute the current angle and position. Remove PID code. - TurnCommand.java: A simple command to automatical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
2020-12-16 - Fixes to the angle code in OctoDriveSubsystem.java. The math is easier to follow, but the accuracy of the angles seems to be hurt by quantizaion effects on the encoder during tight turns. - TurnCom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
2020-12-26 Pass to improve code readability. Documentation and renaming so the more closely matches reference material found here: https://ocw.mit.edu/courses/electrical-engineering-and-computer-science/6-186-m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
2020-12-26 Change OctoDriveSystem odometry code to return a WPILib standard Rotation2d.
2020-12-26 Sync phi computation to match paper @ https://ocw.mit.edu/courses/electrical-engineering-and-computer-science/6-186-mobile-autonomous-systems-laboratory-january-iap-2005/study-materials/odomtutorial.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
    Result doesn't seem quite as good, but it's good enough, and the explanation is much easier to follow.
2020-12-26 Align OctoDriveSububsystem odometry to First Robotics standard interface in https://docs.wpilib.org/en/stable/docs/software/kinematics-and-odometry/differential-drive-odometry.html
2020-12-27 Move EncoderPair class out of the Drive Train.
2020-12-27 Move concept of a "change in encoder state" out of the OctoDriveSubsystem class. Also add an interface for getting the drive train's encoder state.
2020-12-27 Move odometry into its own class.
2020-12-28 Changes driven by review feedback: - Odometry subsystem should be named Subsystem - Separate out the Odometry math from the update. I've made a new class, DifferentialDriveOdometryNoGyro for the math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
2021-06-26 Remove pins from the motor and encoder interface. Will be done using I2C on the second robot. Also remove include directive from the cmakefile. There are now multiple copies of the same file, so incl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
2021-06-27 - Begin adding I2C interface to the hardware abstraction - Switch pins to the rev 2 prototype board - Add rev 2 eagle files.
    [main.brd, main.sch]
2021-07-23 Added a scan for I2C devices durring motor init.
2021-07-24 Removed code unessisary for the new motor controller.
2021-08-01 rev.b board updates - add more I2C busses for expansion - Add 5v power jumpers for expansion - Motor controller is now powered by 5v line from circuit board (less wires)
    [main.brd, main.sch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]
2021-08-01 Change second pin ID constant to get LED status strip working for rev B
2021-08-05 Updated hardwear interface to include more functions from the Wire class.
2021-08-05 Added prototype code for talking to the I2C motor controler.
2021-08-06 Fixed I2C motor connection.
    [command_motor.cpp, command_motor.h]
2021-08-12 GY-521 Gyroscope firmware support.
2021-08-24 Added basics of encoder reading.
2021-08-26 Added begings of support for second i2c bus using soft wire.
2021-08-27 Update rev2 circuit board
    [main.brd, main.sch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]
2021-08-29 Fixed infinite loop bug.
    [command_encoder.cpp, command_encoder.h, command_motor.cpp, hardware_esp8266.h, main.cpp]
2021-09-03 Continued work on making encoder outputs work.
2021-09-03 Fixed encoder output.
2021-09-04 Updated encoder code to allow for looping encoder stuff.
2021-09-19 Files sent for revb board manufacturing
2021-09-19 Wheels & Tires for the RevB Robot.
    [tire.stl, wheel.scad, wheel.stl]
2021-09-28 Firmware tweaks
    - All angles are now 0-2047. That's what the encoder does.
    - Added magic number fo the gyroscope firmware that I found in the gyroscope driver. Wish I had documentation for it.
    - Modified the datasend command to update LEDs with new angle range
    - Modified the datasend command to update LEDs using gyroscope angle
    - Modified the encoder command to calculate speed a bit better.
2021-10-31 Change demo to use throttle instead of second joystick
